icl-rocketry/Ricardo-BlackBox/Hardware/RicardoBlackBox.kicad_pcb

## KiCad design Hardware/RicardoBlackBox.kicad_pcb (2022-11-22)

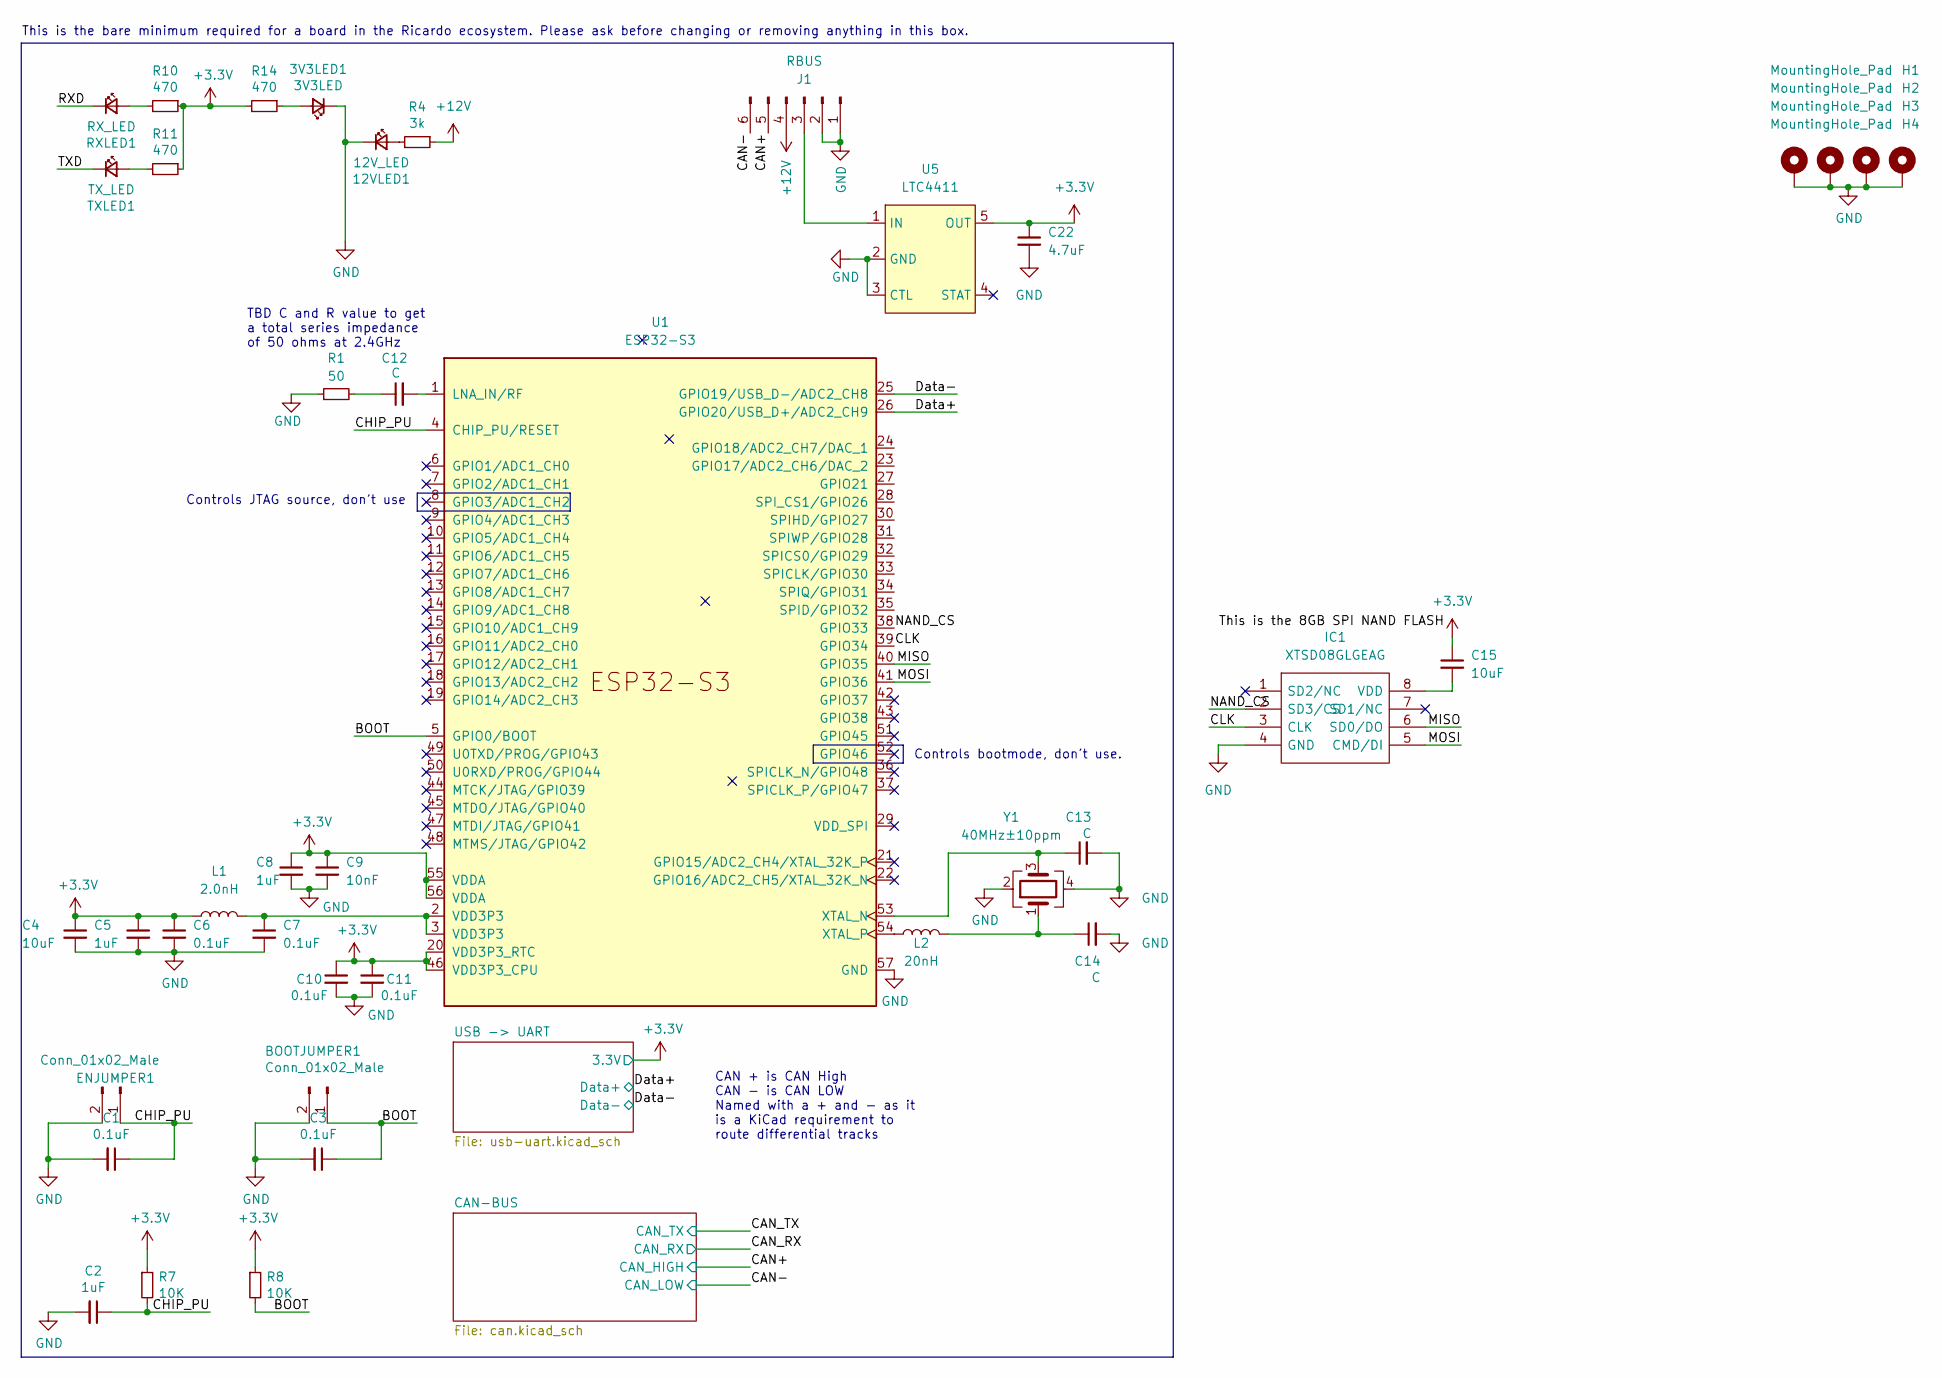
[picture p1: schematic RicardoBlackBox.kicad_sch]

Parts:
3V3LED1: 3V3LED; R_0402_1005Metric
12VLED1: 12V_LED; R_0402_1005Metric
BOOTJUMPER1: Conn_01x02_Male; PinHeader_1x02_P2.54mm_Vertical
C1, C3, C6, C7, C10, C11: 0.1uF; C_0402_1005Metric
C2, C5, C8: 1uF; C_0402_1005Metric
C4, C15: 10uF; C_0402_1005Metric
C9: 10nF; C_0402_1005Metric
C12, C13, C14: C; C_0603_1608Metric
C22: 4.7uF; C_0603_1608Metric
ENJUMPER1: Conn_01x02_Male; PinHeader_1x02_P2.54mm_Vertical
H1, H2, H3, H4: MountingHole_Pad; MountingHole_3.2mm_M3_DIN965_Pad
IC1: XTSD08GLGEAG; SON127P800X600X95-8N; Manufacturer_Part_Number XTSD08GLGEAG
J1: RBUS; Molex_Mini-Fit_Jr_5566-06A_2x03_P4.20mm_Vertical
L1: 2.0nH
L2: 20nH
R1: 50
R4: 3k; R_0402_1005Metric
R7, R8: 10K; R_0402_1005Metric
R10, R11, R14: 470; R_0402_1005Metric
RXLED1: RX_LED; LED_0603_1608Metric
TXLED1: TX_LED; R_0402_1005Metric
U1: ESP32-S3; QFN-56-1EP_7x7mm_P0.4mm_EP5.6x5.6mm
U5: LTC4411; SOT-23-5
Y1: 40MHz±10ppm; Crystal_SMD_2016-4Pin_2.0x1.6mm

Connections:
+3V3: C4.1, C5.1, C6.1, C8.1, C9.1, C10.1, C11.1, C15.1, C22.1, L1.1, R7.1, R8.1, R10.1, R11.1, R14.2, U1.20 (VDD3P3_RTC), U1.46 (VDD3P3_CPU), U1.55 (VDDA), U1.56 (VDDA), U5.5 (OUT); also elsewhere on the board
+12V: J1.4, R4.1
/BOOT: BOOTJUMPER1.1, C3.1, R8.2, U1.5 (GPIO0/BOOT)
/CAN+: J1.5; also elsewhere on the board
/CAN-: J1.6; also elsewhere on the board
/CHIP_PU: C1.1, C2.1, ENJUMPER1.1, R7.2, U1.4 (CHIP_PU/RESET)
/CLK: IC1.3 (CLK), U1.39 (GPIO34)
/Data+: U1.26 (GPIO20/USB_D+/ADC2_CH9); also elsewhere on the board
/Data-: U1.25 (GPIO19/USB_D-/ADC2_CH8); also elsewhere on the board
/MISO: IC1.6 (SD0/DO), U1.40 (GPIO35)
/MOSI: IC1.5 (CMD/DI), U1.41 (GPIO36)
/NAND_CS: IC1.2 (SD3/CS), U1.38 (GPIO33)
/RXD: RXLED1.1 (K)
/TXD: TXLED1.1 (K)
GND: 3V3LED1.1 (K), 12VLED1.1 (K), BOOTJUMPER1.2, C1.2, C2.2, C3.2, C4.2, C5.2, C6.2, C7.2, C8.2, C9.2, C10.2, C11.2, C13.2, C14.2, C22.2, ENJUMPER1.2, H1.1, H2.1, H3.1, H4.1, IC1.4 (GND), J1.1, J1.2, R1.1, U1.57 (GND), U5.2 (GND), U5.3 (CTL), Y1.2, Y1.4; also elsewhere on the board
unnamed: 3V3LED1.2 (A), R14.1
unnamed: 12VLED1.2 (A), R4.2
unnamed: C7.1, L1.2, U1.2 (VDD3P3), U1.3 (VDD3P3)
unnamed: C12.1, R1.2
unnamed: C12.2, U1.1 (LNA_IN/RF)
unnamed: C13.1, U1.53 (XTAL_N), Y1.3
unnamed: C14.1, L2.2, Y1.1
unnamed: C15.2, IC1.8 (VDD)
unnamed: J1.3, U5.1 (IN)
unnamed: L2.1, U1.54 (XTAL_P)
unnamed: R10.2, RXLED1.2 (A)
unnamed: R11.2, TXLED1.2 (A)

Notes on the sheet:
Controls bootmode, don't use.
This is the bare minimum required for a board in the Ricardo ecosystem. Please ask before changing or removing anything in this box.
TBD C and R value to get a total series impedance of 50 ohms at 2.4GHz
CAN + is CAN High CAN - is CAN LOW Named with a + and - as it is a KiCad requirement to route differential tracks
Controls JTAG source, don't use

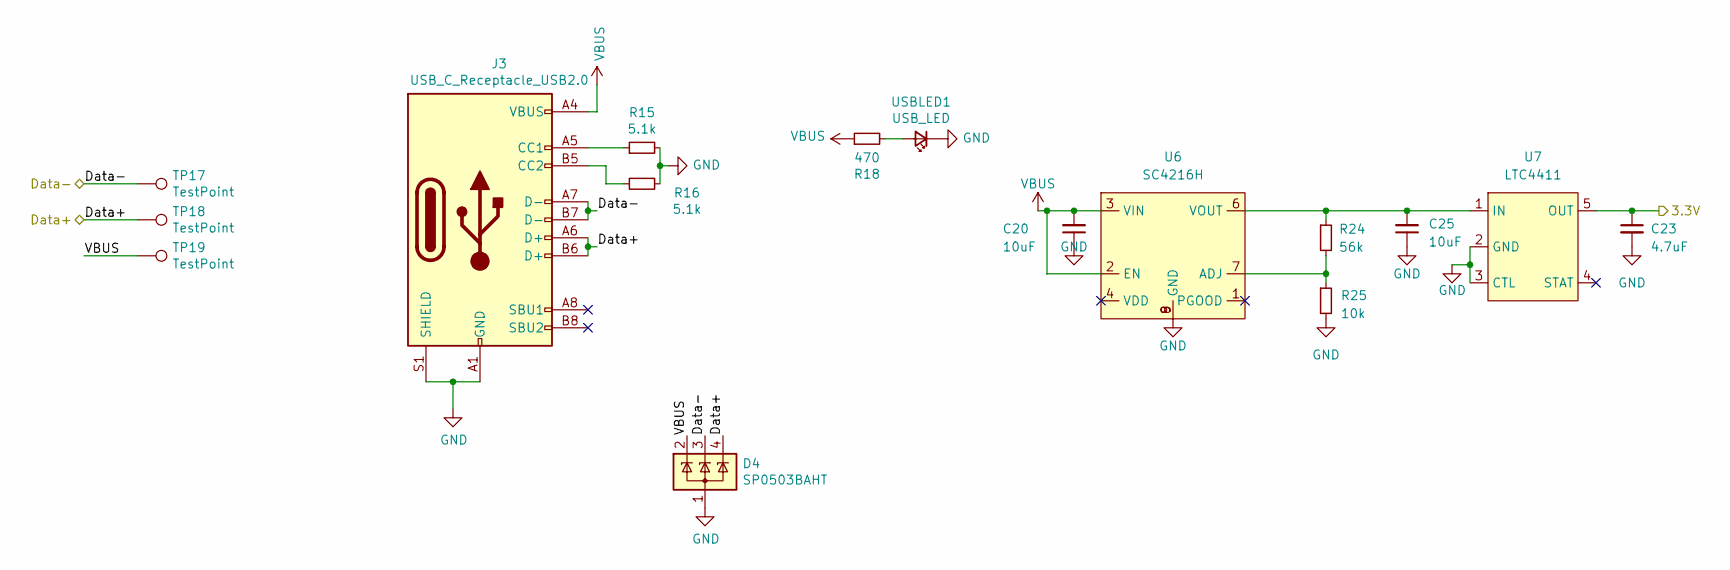
[picture p2: schematic usb-uart.kicad_sch]

Parts:
C20, C25: 10uF; C_0603_1608Metric
C23: 4.7uF; C_0603_1608Metric
D4: SP0503BAHT; SOT-143
J3: USB_C_Receptacle_USB2.0; USB_C_Receptacle_GCT_USB4085
R15, R16: 5.1k; R_0402_1005Metric
R18: 470; R_0402_1005Metric
R24: 56k; R_0402_1005Metric
R25: 10k; R_0402_1005Metric
TP17, TP18, TP19: TestPoint; TestPoint_Pad_D1.0mm
U6: SC4216H; SOIC127P599X175-9N
U7: LTC4411; SOT-23-5
USBLED1: USB_LED; LED_0603_1608Metric

Connections:
+3V3: C23.1, U7.5 (OUT); also elsewhere on the board
/Data+: D4.4 (K), J3.A6 (D+), J3.B6 (D+), TP18.1; also elsewhere on the board
/Data-: D4.3 (K), J3.A7 (D-), J3.B7 (D-), TP17.1; also elsewhere on the board
GND: C20.1, C23.2, C25.1, D4.1 (A), J3.A1 (GND), J3.A12 (GND), J3.B1 (GND), J3.B12 (GND), J3.S1 (SHIELD), R15.2, R16.1, R25.2, U6.8 (GND), U6.9 (GND), U7.2 (GND), U7.3 (CTL), USBLED1.1 (K); also elsewhere on the board
unnamed: C25.2, R24.1, U6.6 (VOUT), U7.1 (IN)
unnamed: J3.A5 (CC1), R15.1
unnamed: J3.B5 (CC2), R16.2
unnamed: R18.2, USBLED1.2 (A)
unnamed: R24.2, R25.1, U6.7 (ADJ)
VBUS: C20.2, D4.2 (K), J3.A4 (VBUS), J3.A9 (VBUS), J3.B4 (VBUS), J3.B9 (VBUS), R18.1, TP19.1, U6.2 (EN), U6.3 (VIN)

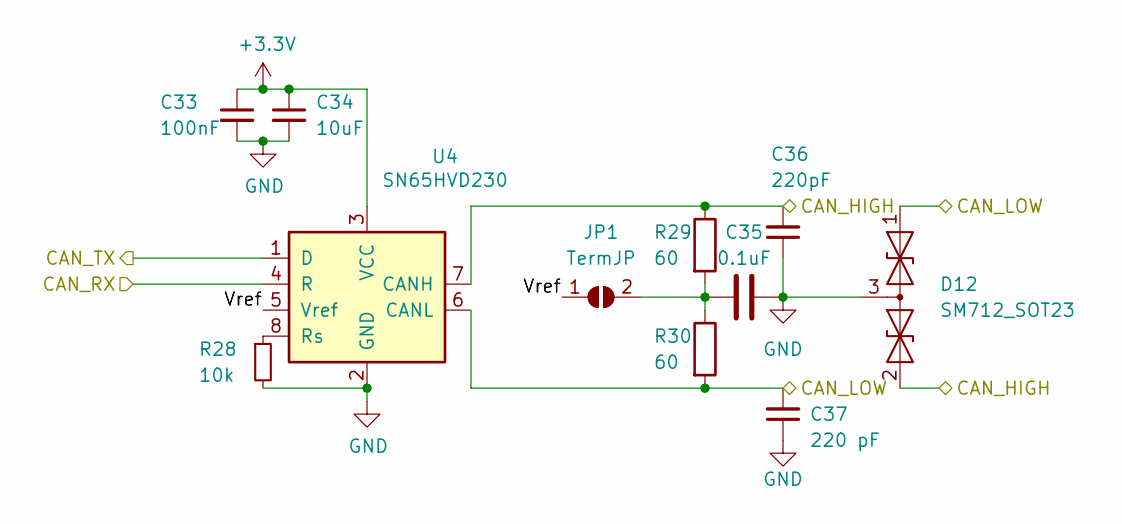
[picture p3: schematic can.kicad_sch]

Parts:
C33: 100nF; C_0402_1005Metric
C34: 10uF; C_0603_1608Metric
C35: 0.1uF; C_0402_1005Metric
C36: 220pF; C_0402_1005Metric
C37: 220 pF; C_0402_1005Metric
D12: SM712_SOT23; SOT-23
JP1: TermJP
R28: 10k; R_0402_1005Metric
R29, R30: 60; R_0402_1005Metric
U4: SN65HVD230; SOIC-8_3.9x4.9mm_P1.27mm

Connections:
+3V3: C33.1, C34.1, U4.3 (VCC); also elsewhere on the board
/CAN+: C36.2, D12.2 (A2), R29.1, U4.7 (CANH); also elsewhere on the board
/CAN-: C37.2, D12.1 (A1), R30.2, U4.6 (CANL); also elsewhere on the board
/CAN-BUS/Vref: JP1.1 (A), U4.5 (Vref)
/CAN_RX: U4.4 (R)
/CAN_TX: U4.1 (D)
GND: C33.2, C34.2, C35.2, C36.1, C37.1, D12.3 (common), R28.2, U4.2 (GND); also elsewhere on the board
unnamed: C35.1, JP1.2 (B), R29.2, R30.1
unnamed: R28.1, U4.8 (Rs)

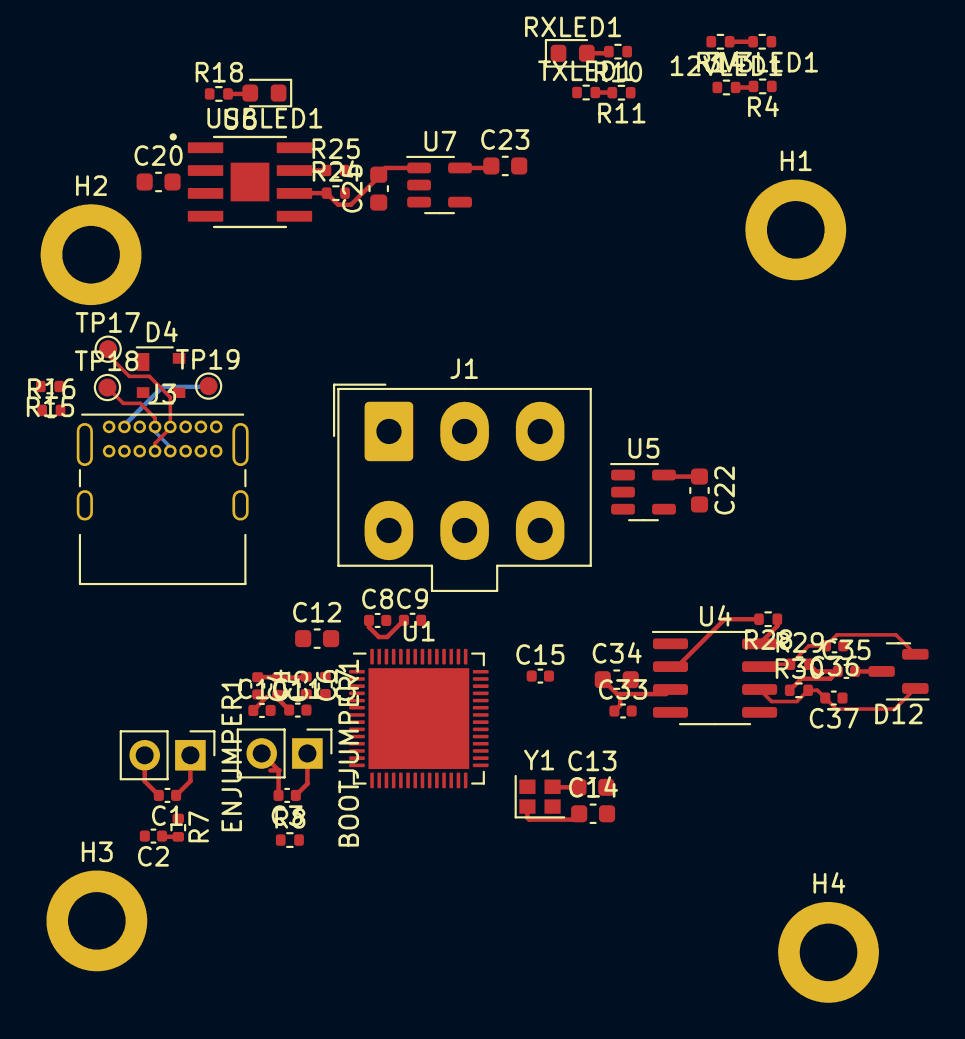
[picture p4: board RicardoBlackBox.kicad_pcb from above]

Board: 2 copper layers, 62 parts (0 on the bottom side), 26 nets.
