icl-rocketry/Ricardo-BlackBox/Firmware/src/main.cpp

#include "freertos/FreeRTOS.h"
#include "freertos/task.h"
#include "esp_task_wdt.h"

#include <Arduino.h>
#define ARDUINO_LOOP_STACK_SIZE 8192


#include <exception>

#include "system.h"



static constexpr bool exceptionsEnabled = true; //for debugging -> will integrate this into the sd configuration options later


TaskHandle_t loopTaskHandle = NULL;

System ricSystem;


void setup_task()
{
    //MUST CALL CORE SYSTEM SETUP
    ricSystem.coreSystemSetup();
}

void inner_loop_task()
{
    //must call core system update
    ricSystem.coreSystemUpdate();
}

void loopTask(void *pvParameters)
{
    // esp_log_level_set("*", ESP_LOG_INFO); 
    setup_task();
    for(;;) {
        inner_loop_task();
        vTaskDelay(1); // this is important to allow the watchdog to be reset, and to let any other threads on the core work
    }
}

extern "C" void app_main()
{
    initArduino(); //probably dont even need this
    xTaskCreateUniversal(loopTask, "loopTask", ARDUINO_LOOP_STACK_SIZE, NULL, 1, &loopTaskHandle, 1);
}
