icl-rocketry/Ricardo-BlackBox/(commit log)

2023-01-31 AsOf31/01/2023
    Schematic should be done, PCB beginning to be done
    [Ricardo-BlackBox.kicad_pcb, Ricardo-BlackBox.kicad_sch, can.kicad_sch, power.kicad_sch, usb-uart.kicad_sch]
2023-06-03 03/06/2023RicardoBlackBoxAfterICLRMeeting
    13:31
    [Ricardo-BlackBoxNEW.kicad_pcb]
2023-06-10 10_06_2023BlackBox
    All files for Black Box needed are in this
    [Ricardo-BlackBoxNEW.kicad_pcb, Ricardo-BlackBoxNEW.kicad_sch, usb-uart.kicad_sch]
2023-06-20 Black_Box_20/06/2023_THIS_HAS_ALL_FOLDER_HAS_FILES
    This folder has the board up to date
    [Ricardo-BlackBoxNEW.kicad_pcb]
2023-08-21 RicardoBlackBox_21_08_2023
    Changed some silkscreens and removed some disconnected tracks
    [Ricardo-BlackBoxNEWFinal.kicad_pcb]
2023-09-29 z
    sorted into hardware and firmware
    [NewRicardBlackBox.kicad_pcb, NewRicardoBlackBox.kicad_sch, Ricardo-BlackBox.kicad_pcb, Ricardo-BlackBox.kicad_sch, Ricardo-BlackBoxNEW.kicad_pcb, Ricardo-BlackBoxNEW.kicad_sch, Ricardo-BlackBoxNEWFinal.kicad_pcb, Ricardo-BlackBoxNEWFinal.kicad_sch]
